AnonymousVikram/e155-project/README.md

# E155 Final Project Portfolio Website Template

This repository contains a template for a final project website for E155 (MicroPs) at Harvey Mudd College.
