AnonymousVikram/e155-project/docs/documentation.qmd

---
title: Documentation
---

Our new piece of hardware that we attempted to incorporate into our design was the ArduCAM Mini 2MP camera module that incoprated an OV2640 camera. The camera itself has two internal bank registers that allowed the user to configure the camera settings such as resolution and output format. The module produce by ArduCAM incorporated another bank of registers that allowed users to quickly configure and access data. 

In terms of hardware for our project, we used an FPGA and MCU. Our bill of materials is produced below:

| Name | Description | Manufacturer | Part Number/ID | Quantity | Unit Price | Links |
|---|---|---|---|---|---|---|
| VGA Breakout Board | Female Plug to Terminal Block Breakout | Adafruit | 3124 | 1 | $4.50 | [Adafruit.com](https://www.adafruit.com/product/3124) |
| VGA Connector | Male connectors on either end | Stockroom | N/A | 1 | Stockroom |  |

Our electrical schematic is shown below:

:::{.figure}
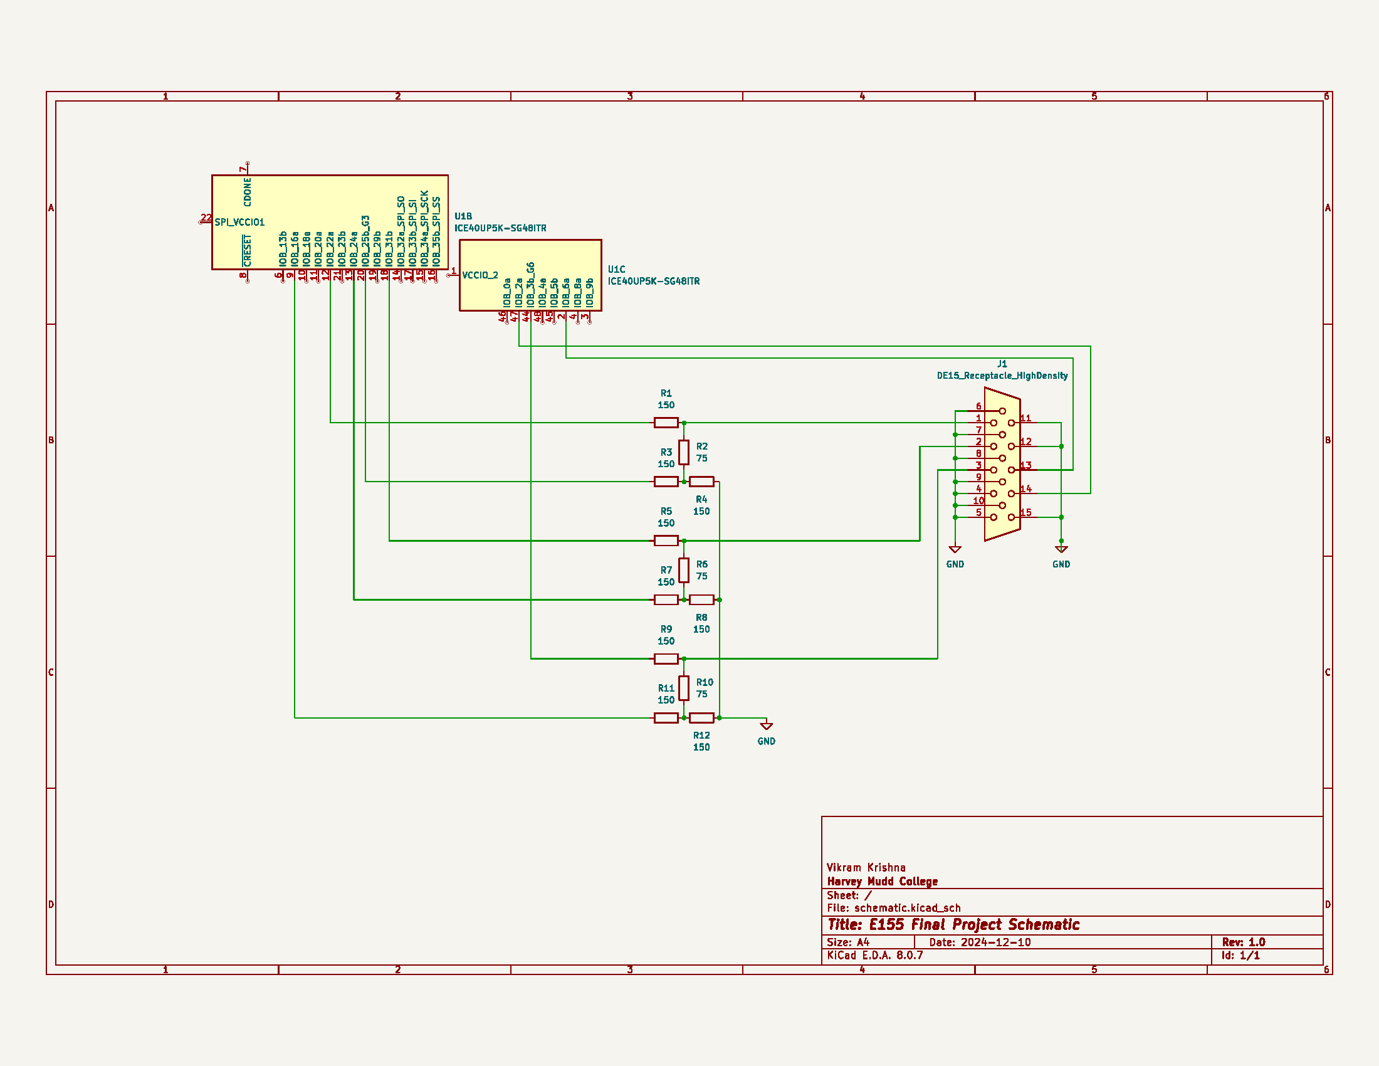
[picture p3: docs/images/schematic.png]
Schematic for Edge Detection System

:::

Our published source code can be found in our Github repository [here](https://https://github.com/troyrkaufman/e155_edge_detection_hardware_accelerator).

:::{.figure}
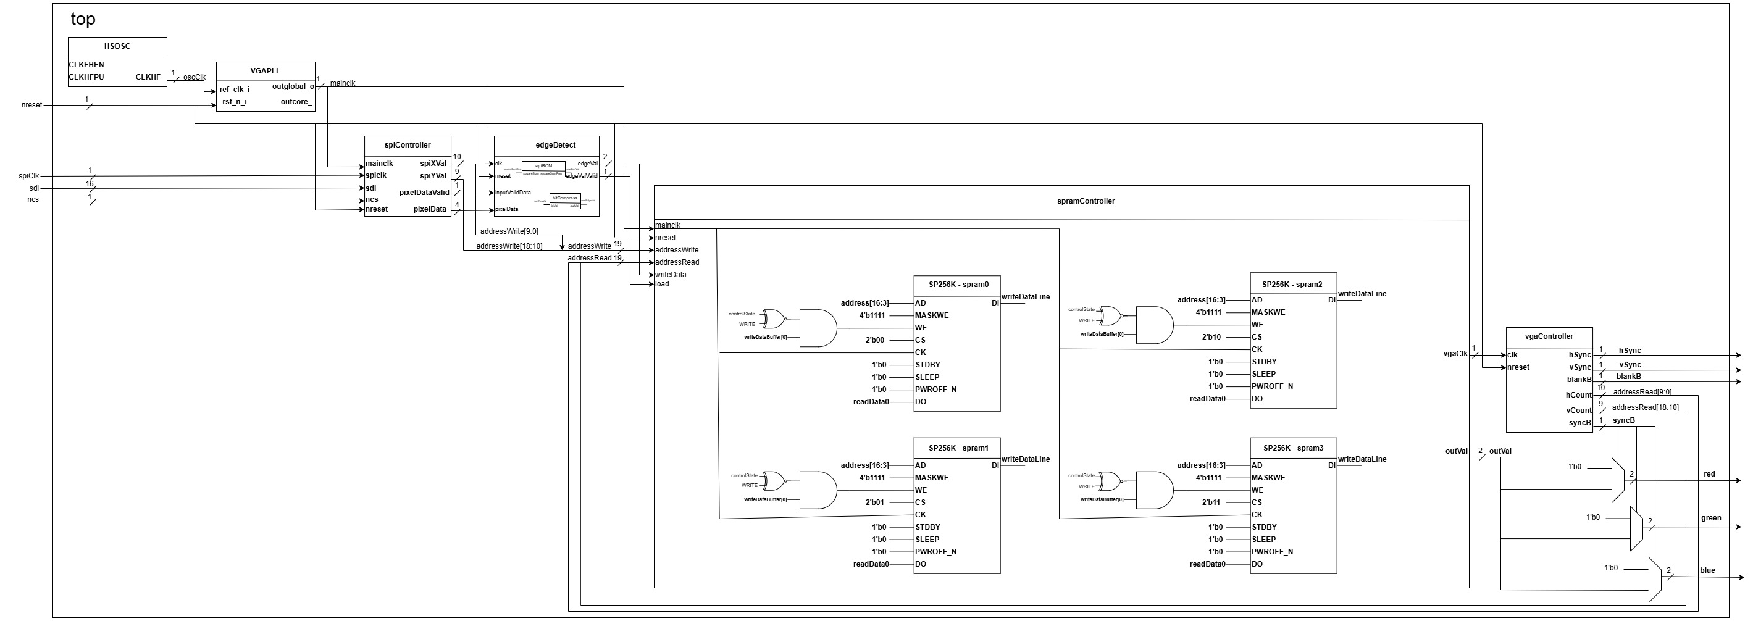
[picture p4: docs/images/fpgaBlocks.jpg]
FPGA Block Diagram

:::
