AnonymousVikram/e155-project/docs/images/blockdiagram.jpg

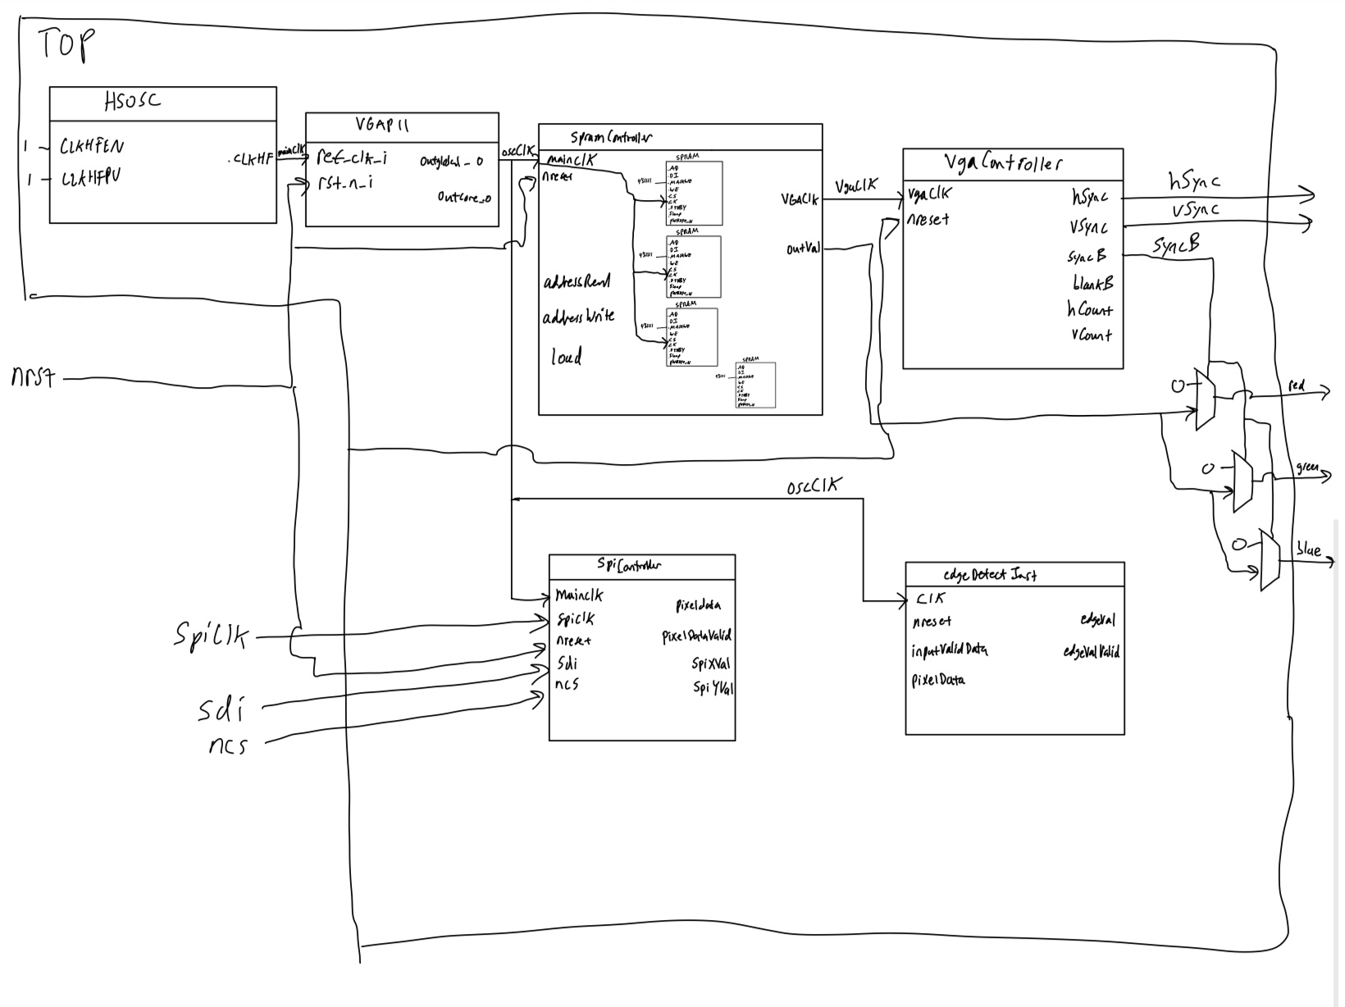
docs/images/blockdiagram.jpg
