AnonymousVikram/e155-project/schematic/schematic.pdf

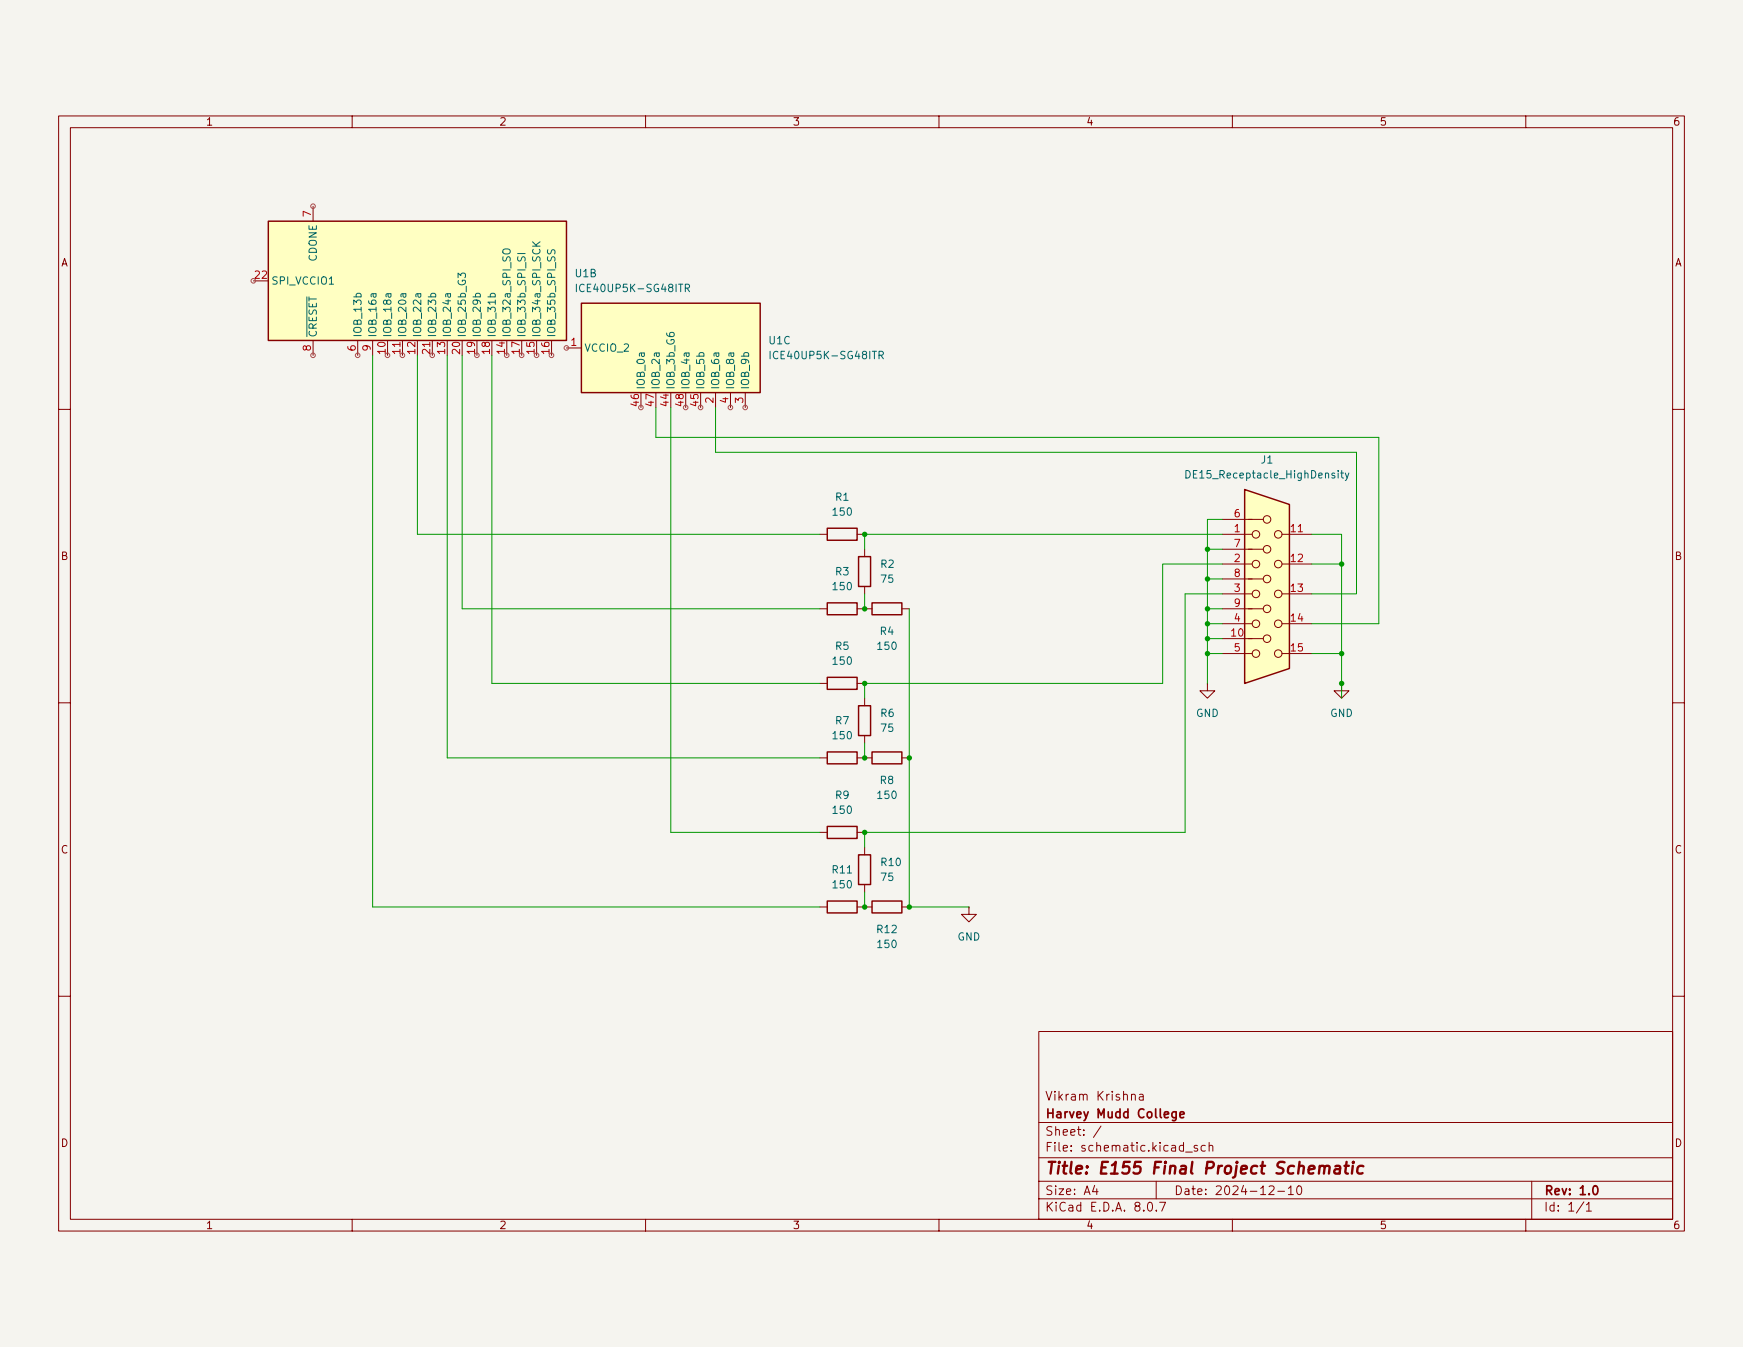
[picture p8: page 1]
