AnonymousVikram/e155-project/(commit log)

2024-12-10 updated schematic
2024-12-10 schematic in kicad
    [schematic.kicad_pcb, schematic.kicad_sch]
